eyhxh/3Dprint-mini-RC-excavator-V2/readme/img/bottom.jpeg

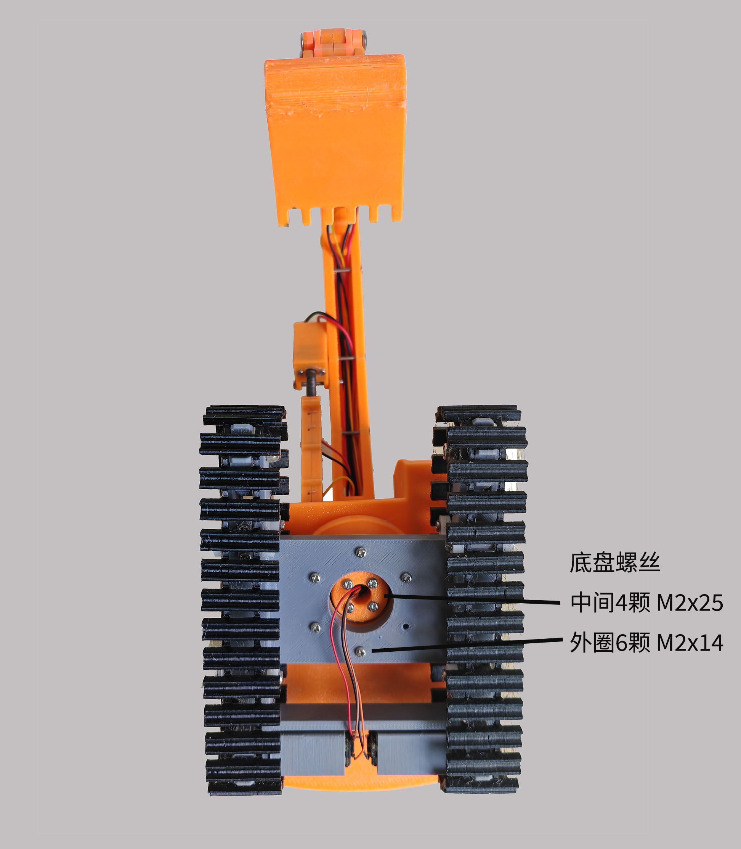
readme/img/bottom.jpeg
