eyhxh/3Dprint-mini-RC-excavator-V2/STL/tpu print/tpu履带29-修正.STL

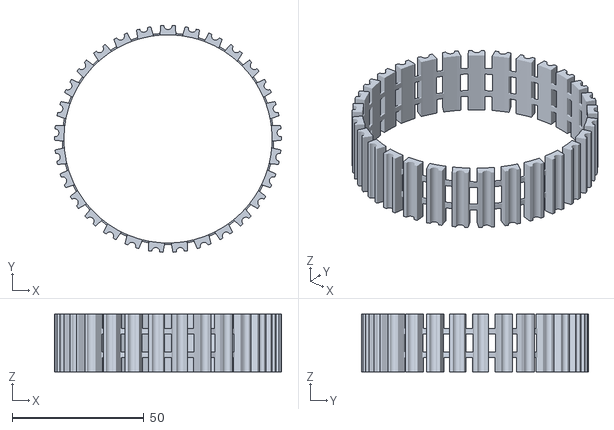
[picture p7: CAD file, 2025-03-01]
STL/tpu print/tpu履带29-修正.STL
86.2 x 86.0 x 22.0
