eyhxh/3Dprint-mini-RC-excavator-V2/STL/装配体1^新旋转机构.STL

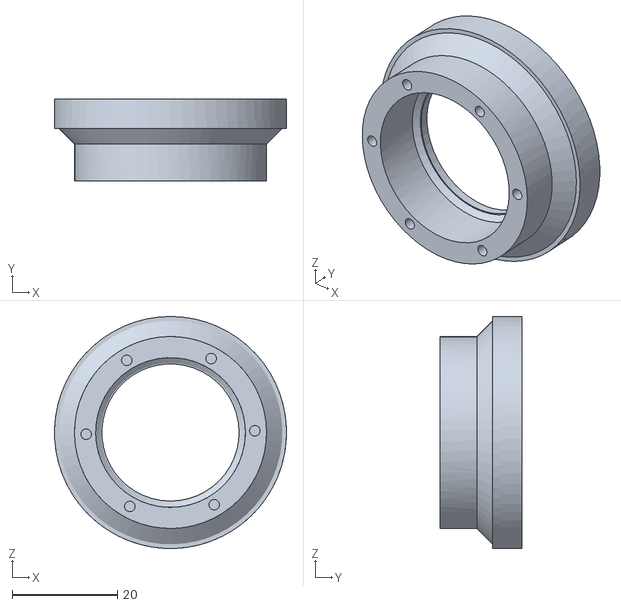
[picture p8: CAD file, 2025-03-01]
STL/装配体1^新旋转机构.STL
44.0 x 15.6 x 44.0
