eyhxh/3Dprint-mini-RC-excavator-V2/STL/试装1 - tpu底盘系统.SLDPRT-1 N20防尘-3.STL

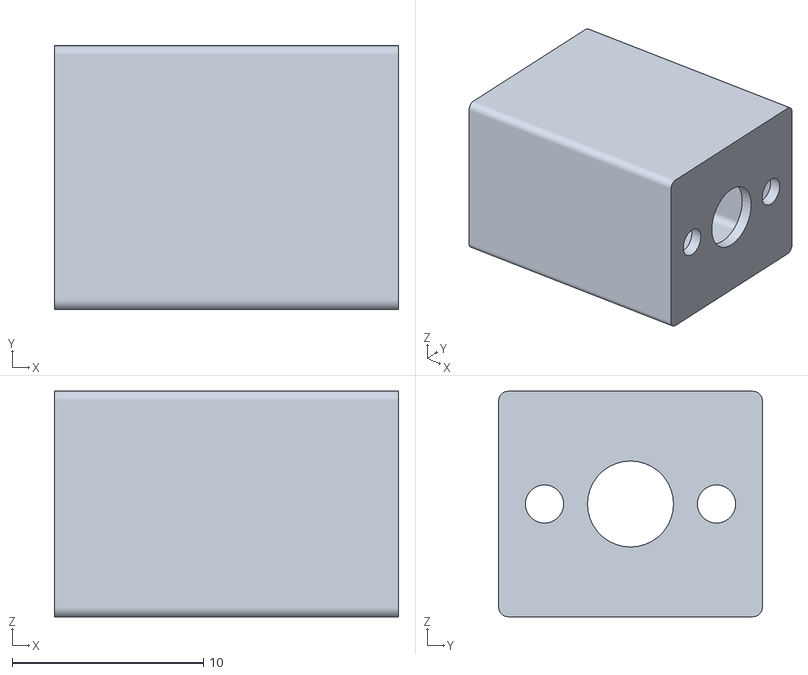
[picture p10: CAD file, 2025-03-01]
STL/试装1 - tpu底盘系统.SLDPRT-1 N20防尘-3.STL
18.0 x 13.8 x 11.8
