eyhxh/3Dprint-mini-RC-excavator-V2/STL/试装1 - tpu底盘系统.SLDPRT-1 tpu底盘-1.STL

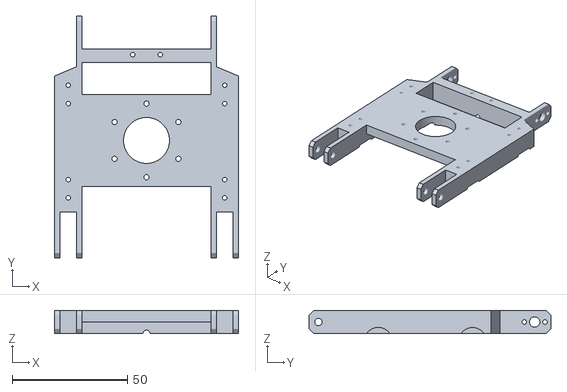
[picture p11: CAD file, 2025-03-01]
STL/试装1 - tpu底盘系统.SLDPRT-1 tpu底盘-1.STL
80.0 x 105.0 x 10.0
