eyhxh/3Dprint-mini-RC-excavator-V2/STL/试装1 - tpu底盘系统.SLDPRT-1 履带电机挡板-1.STL

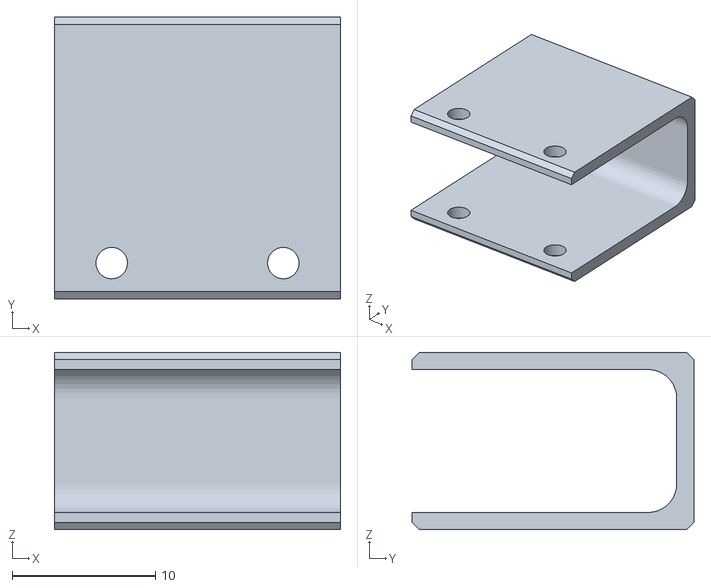
[picture p12: CAD file, 2025-03-01]
STL/试装1 - tpu底盘系统.SLDPRT-1 履带电机挡板-1.STL
20.0 x 19.7 x 12.4
