eyhxh/3Dprint-mini-RC-excavator-V2/STL/试装1 - 主体带推杆系统-1 主体系统-1 主体底-1.STL

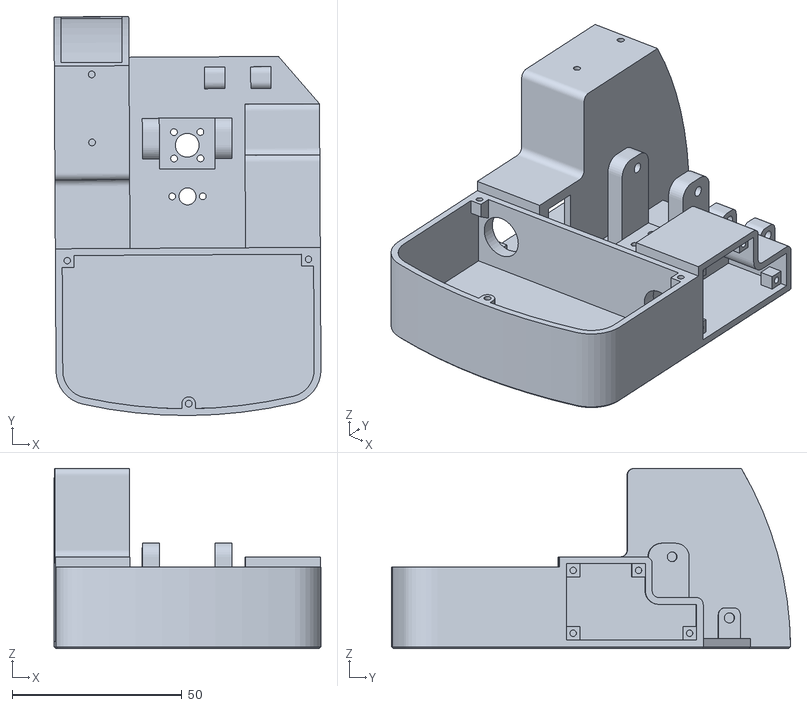
[picture p13: CAD file, 2025-03-01]
STL/试装1 - 主体带推杆系统-1 主体系统-1 主体底-1.STL
78.6 x 117.4 x 53.0
