eyhxh/3Dprint-mini-RC-excavator-V2/STL/试装1 - 主体带推杆系统-1 推杆3-m4-3 新推杆活动杆壳-m4-2.STL

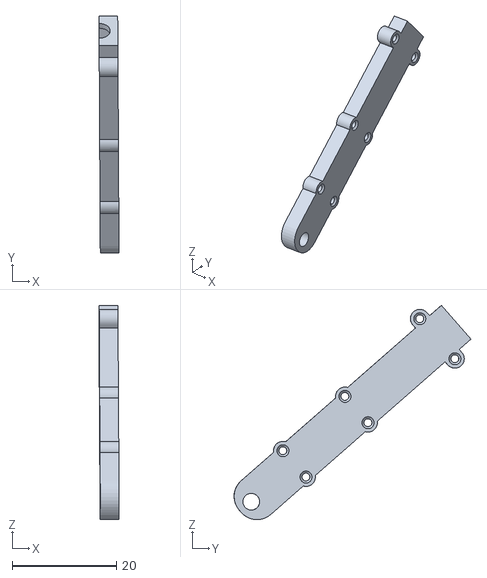
[picture p16: CAD file, 2025-03-01]
STL/试装1 - 主体带推杆系统-1 推杆3-m4-3 新推杆活动杆壳-m4-2.STL
3.86 x 45.4 x 41.1
