eyhxh/3Dprint-mini-RC-excavator-V2/STL/试装1 - 主体带推杆系统-1 主体系统-1 挖斗-1.STL

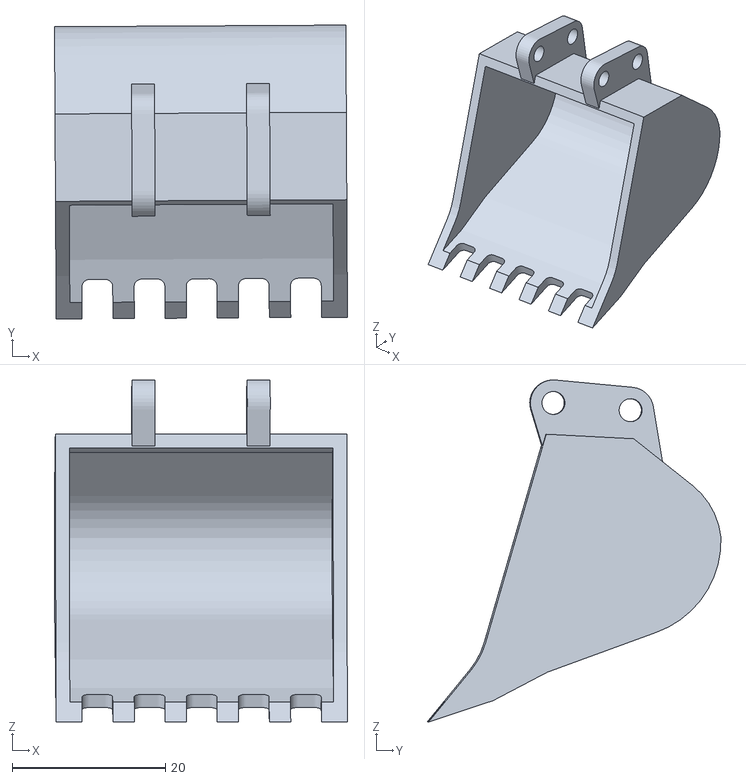
[picture p18: CAD file, 2025-03-01]
STL/试装1 - 主体带推杆系统-1 主体系统-1 挖斗-1.STL
38.2 x 38.3 x 44.6
