eyhxh/3Dprint-mini-RC-excavator-V2/STL/试装1 - 主体带推杆系统-1 主体系统-1 实体1-2.STL

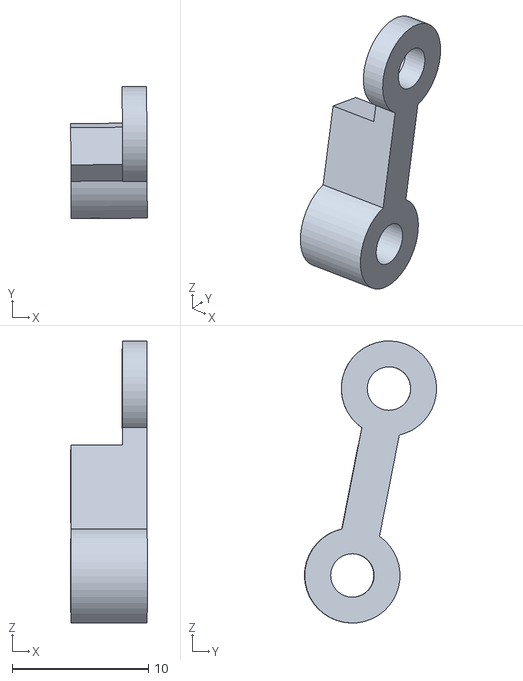
[picture p19: CAD file, 2025-03-01]
STL/试装1 - 主体带推杆系统-1 主体系统-1 实体1-2.STL
5.64 x 9.72 x 20.7
