eyhxh/3Dprint-mini-RC-excavator-V2/STL/试装1 - 新旋转机构-1 外套垫圈-1.STL

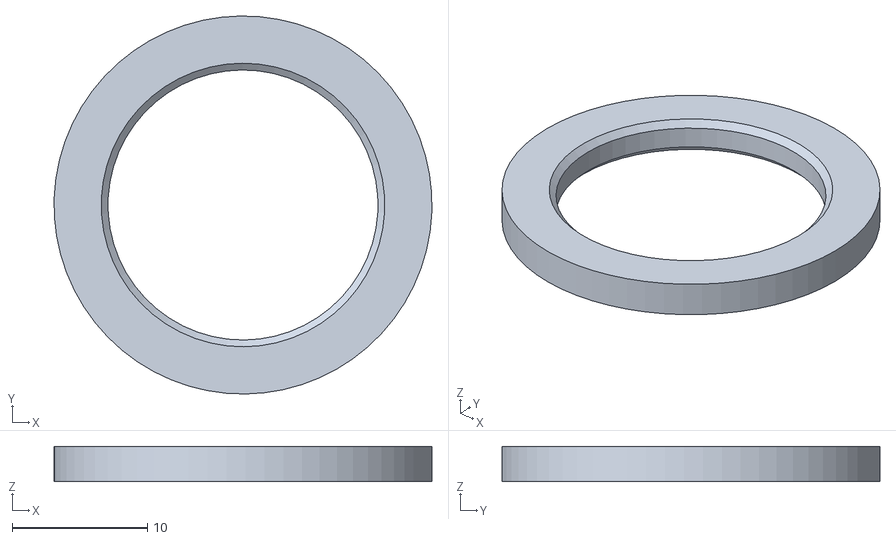
[picture p20: CAD file, 2025-03-01]
STL/试装1 - 新旋转机构-1 外套垫圈-1.STL
28.0 x 28.0 x 2.60
