eyhxh/3Dprint-mini-RC-excavator-V2/STL/试装1 - 主体带推杆系统-1 推杆3-m4-3 推杆2N20防尘固定0.2间隙-1.STL

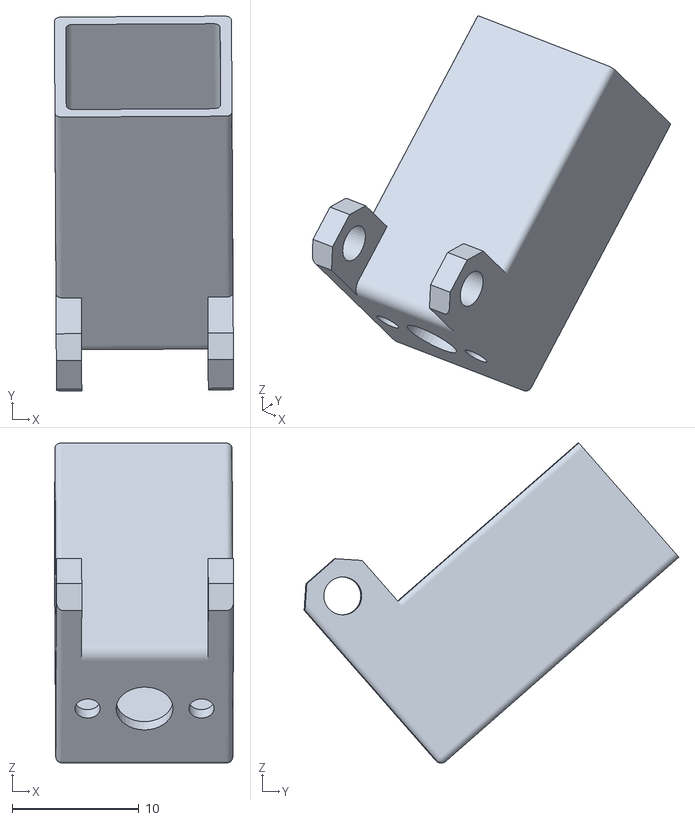
[picture p21: CAD file, 2025-03-01]
STL/试装1 - 主体带推杆系统-1 推杆3-m4-3 推杆2N20防尘固定0.2间隙-1.STL
14.2 x 29.6 x 25.3
