eyhxh/3Dprint-mini-RC-excavator-V2/STL/试装1 - 主体带推杆系统-1 主体系统-1 实体1-1.STL

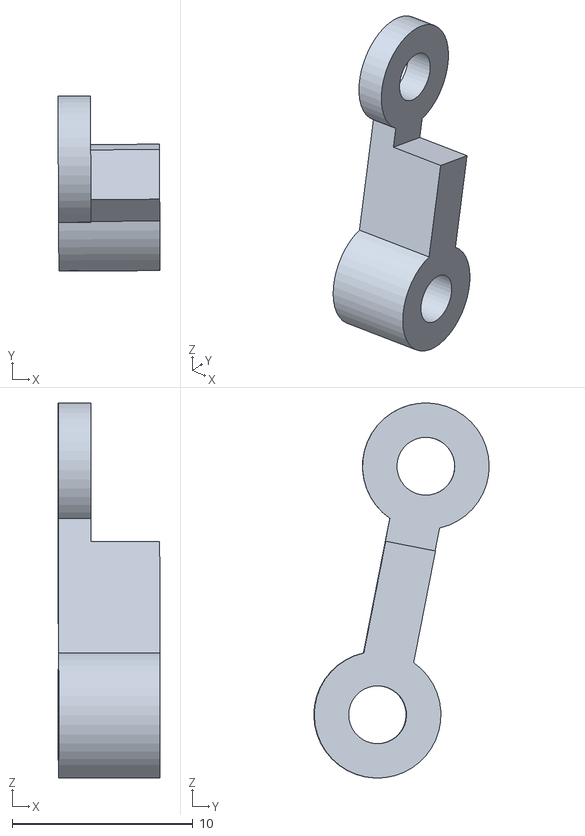
[picture p23: CAD file, 2025-03-01]
STL/试装1 - 主体带推杆系统-1 主体系统-1 实体1-1.STL
5.65 x 9.70 x 20.7
