eyhxh/3Dprint-mini-RC-excavator-V2/STL/试装1 - tpu底盘系统.SLDPRT-1 tpu主动轮-6.STL

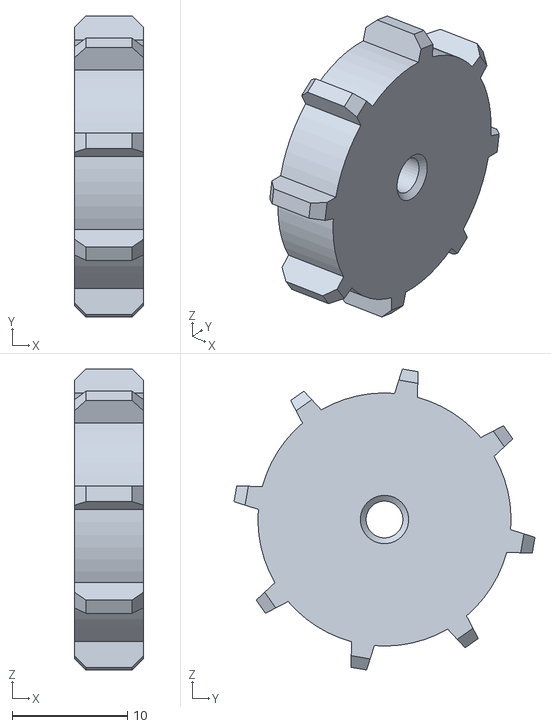
[picture p24: CAD file, 2025-03-01]
STL/试装1 - tpu底盘系统.SLDPRT-1 tpu主动轮-6.STL
6.00 x 26.2 x 26.2
