eyhxh/3Dprint-mini-RC-excavator-V2/STL/试装1 - 主体带推杆系统-1 主体系统-1 电池仓盖^主体系统-1.STL

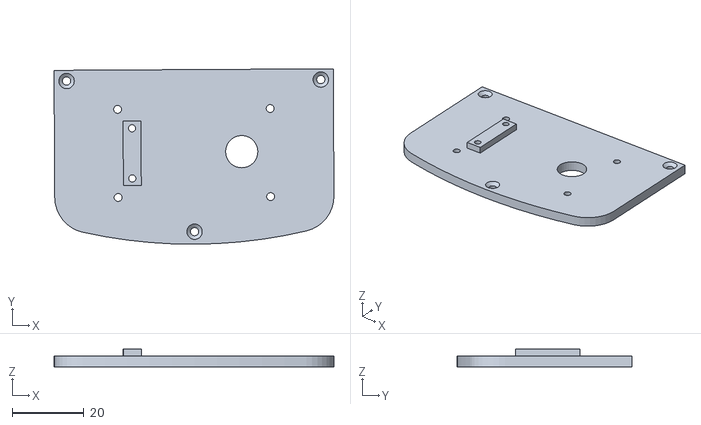
[picture p25: CAD file, 2025-03-01]
STL/试装1 - 主体带推杆系统-1 主体系统-1 电池仓盖^主体系统-1.STL
78.2 x 49.0 x 5.00
