eyhxh/3Dprint-mini-RC-excavator-V2/STL/主轴齿轮适配体间隙0.4.STL

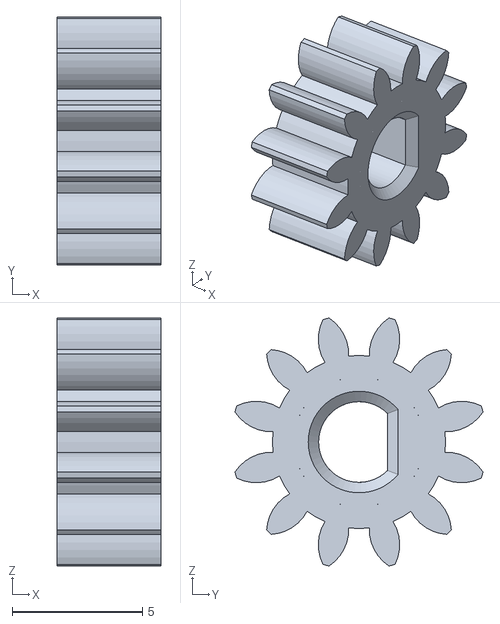
[picture p26: CAD file, 2025-03-01]
STL/主轴齿轮适配体间隙0.4.STL
4.00 x 9.53 x 9.53
