eyhxh/3Dprint-mini-RC-excavator-V2/STL/试装1 - 主体带推杆系统-1 主体系统-1 主控仓盖^主体系统-1.STL

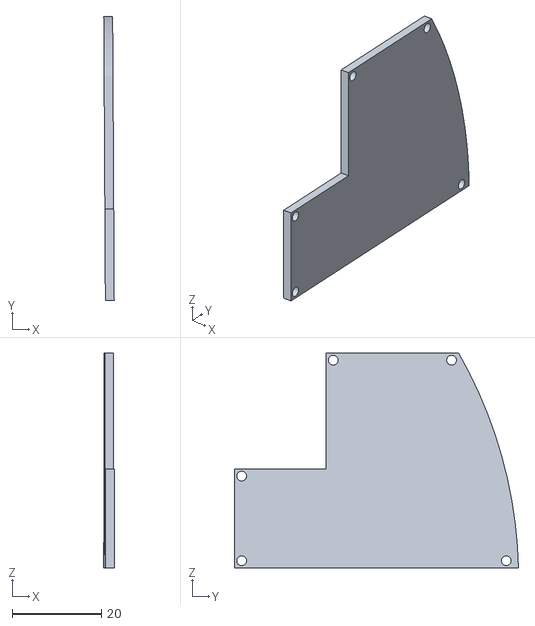
[picture p27: CAD file, 2025-03-01]
STL/试装1 - 主体带推杆系统-1 主体系统-1 主控仓盖^主体系统-1.STL
2.36 x 63.7 x 48.2
