eyhxh/3Dprint-mini-RC-excavator-V2/STL/试装1 - 主体带推杆系统-1 主体系统-1 小臂-1.STL

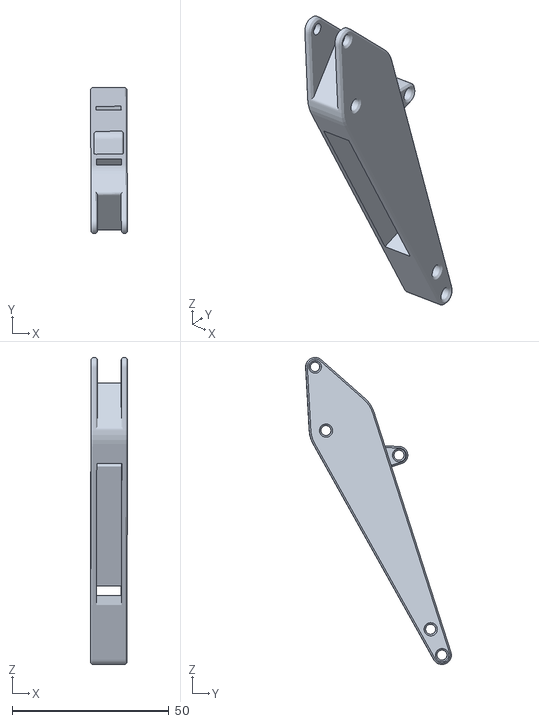
[picture p29: CAD file, 2025-03-01]
STL/试装1 - 主体带推杆系统-1 主体系统-1 小臂-1.STL
11.9 x 46.6 x 98.0
