eyhxh/3Dprint-mini-RC-excavator-V2/STL/试装1 - 主体带推杆系统-1 主体系统-1 挖斗连杆2-2.STL

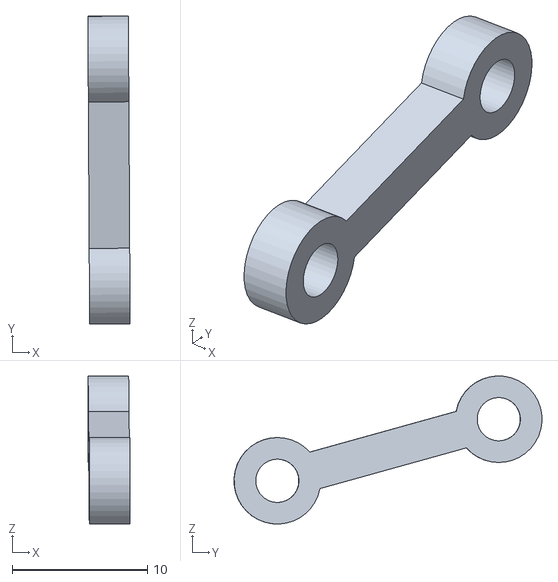
[picture p30: CAD file, 2025-03-01]
STL/试装1 - 主体带推杆系统-1 主体系统-1 挖斗连杆2-2.STL
3.13 x 22.8 x 10.9
