eyhxh/3Dprint-mini-RC-excavator-V2/STL/试装1 - 新旋转机构-1 新内套垫圈-1.STL

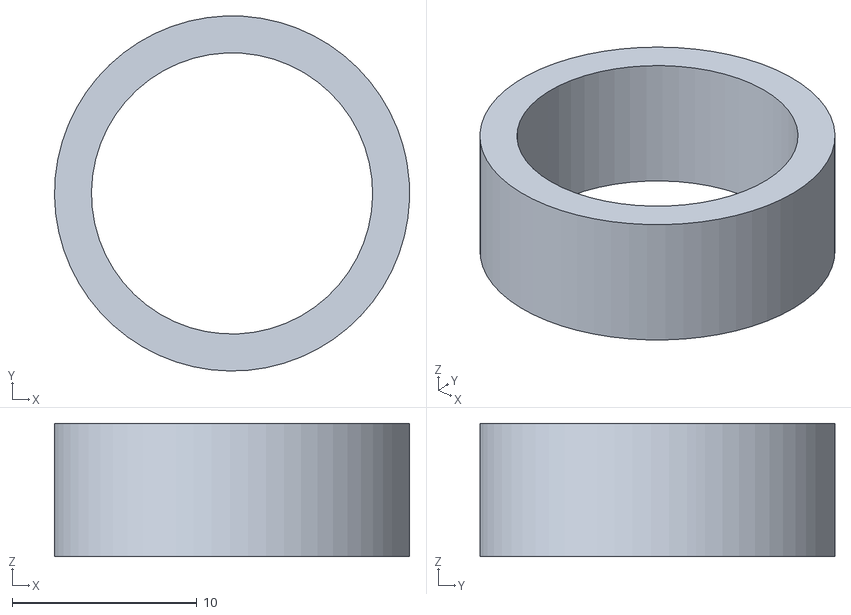
[picture p32: CAD file, 2025-03-01]
STL/试装1 - 新旋转机构-1 新内套垫圈-1.STL
19.2 x 19.2 x 7.20
