eyhxh/3Dprint-mini-RC-excavator-V2/STL/试装1 - 主体带推杆系统-1 主体系统-1 引擎壳-1.STL

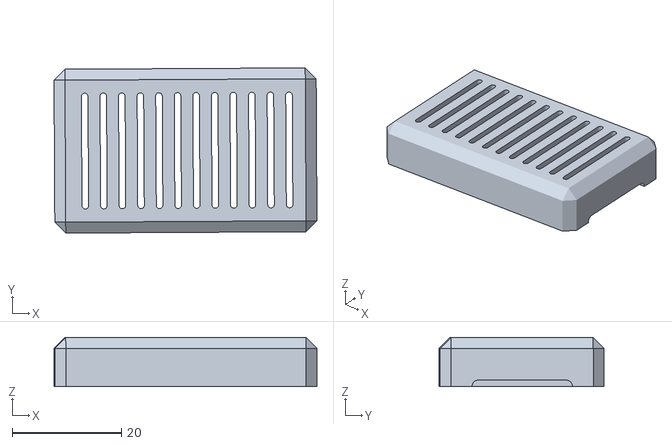
[picture p33: CAD file, 2025-03-01]
STL/试装1 - 主体带推杆系统-1 主体系统-1 引擎壳-1.STL
48.1 x 30.2 x 9.00
