eyhxh/3Dprint-mini-RC-excavator-V2/STL/试装1 - 主体带推杆系统-1 主体系统-1 零件1^主体系统-1.STL

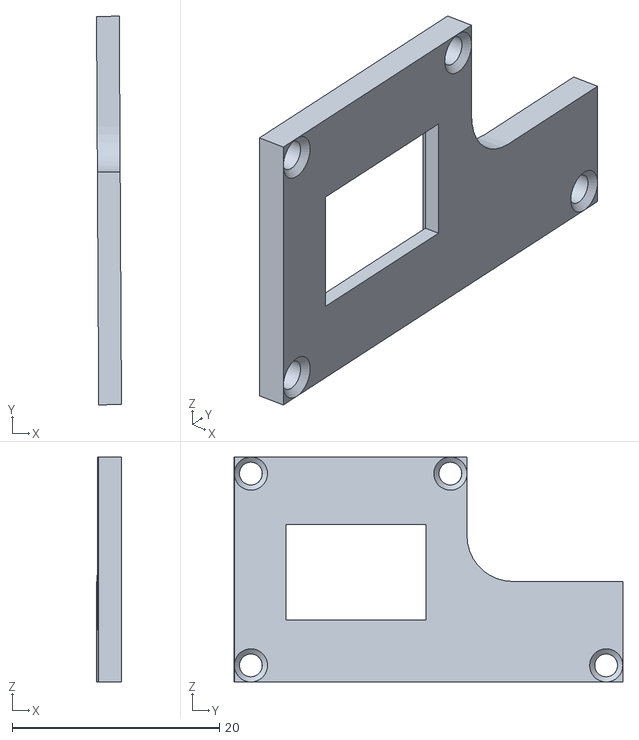
[picture p34: CAD file, 2025-03-01]
STL/试装1 - 主体带推杆系统-1 主体系统-1 零件1^主体系统-1.STL
2.41 x 37.5 x 21.7
