eyhxh/3Dprint-mini-RC-excavator-V2/STL/试装1 - 主体带推杆系统-1 主体系统-1 大臂-1.STL

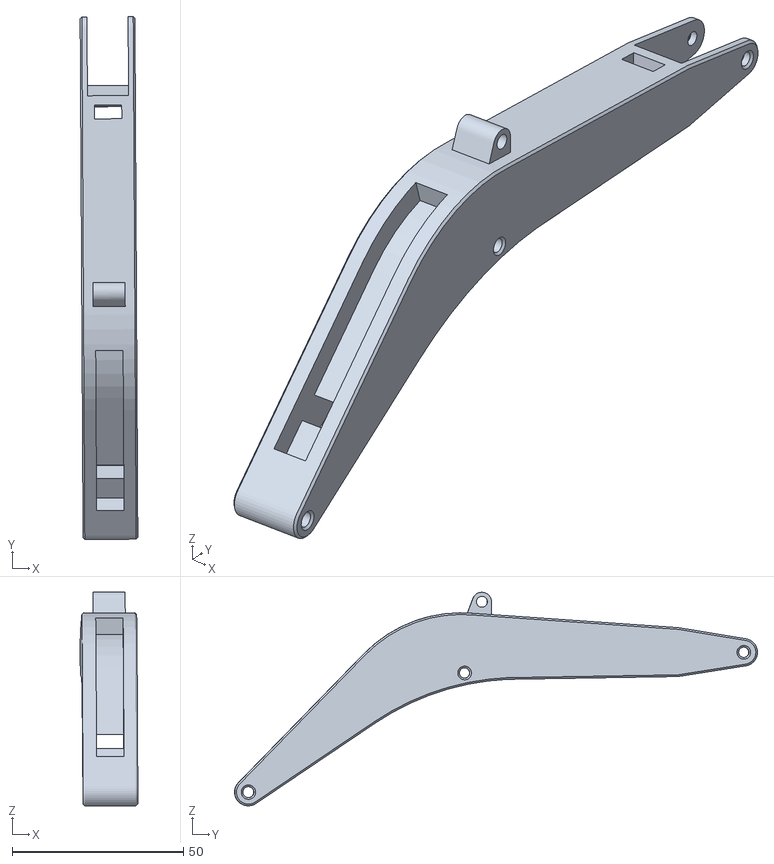
[picture p35: CAD file, 2025-03-01]
STL/试装1 - 主体带推杆系统-1 主体系统-1 大臂-1.STL
16.9 x 152.7 x 62.4
