eyhxh/3Dprint-mini-RC-excavator-V2/STL/试装1 - 主体带推杆系统-1 推杆3-m4-1 新推杆活动杆壳-m4-2.STL

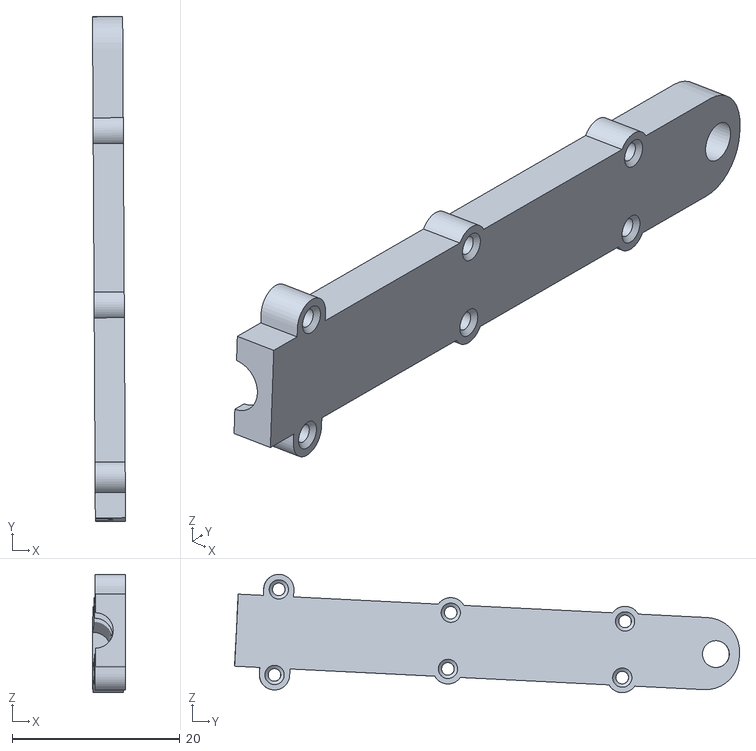
[picture p37: CAD file, 2025-03-01]
STL/试装1 - 主体带推杆系统-1 推杆3-m4-1 新推杆活动杆壳-m4-2.STL
3.94 x 60.2 x 14.1
