eyhxh/3Dprint-mini-RC-excavator-V2/STL/试装1 - tpu底盘系统.SLDPRT-1 轴承盖板-1.STL

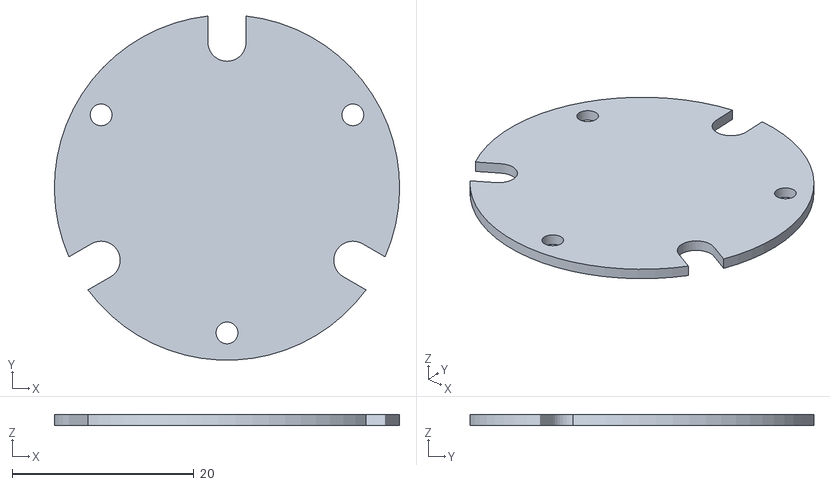
[picture p38: CAD file, 2025-03-01]
STL/试装1 - tpu底盘系统.SLDPRT-1 轴承盖板-1.STL
38.0 x 37.9 x 1.20
