eyhxh/3Dprint-mini-RC-excavator-V2/STL/试装1 - 新旋转机构-1 新内套-1.STL

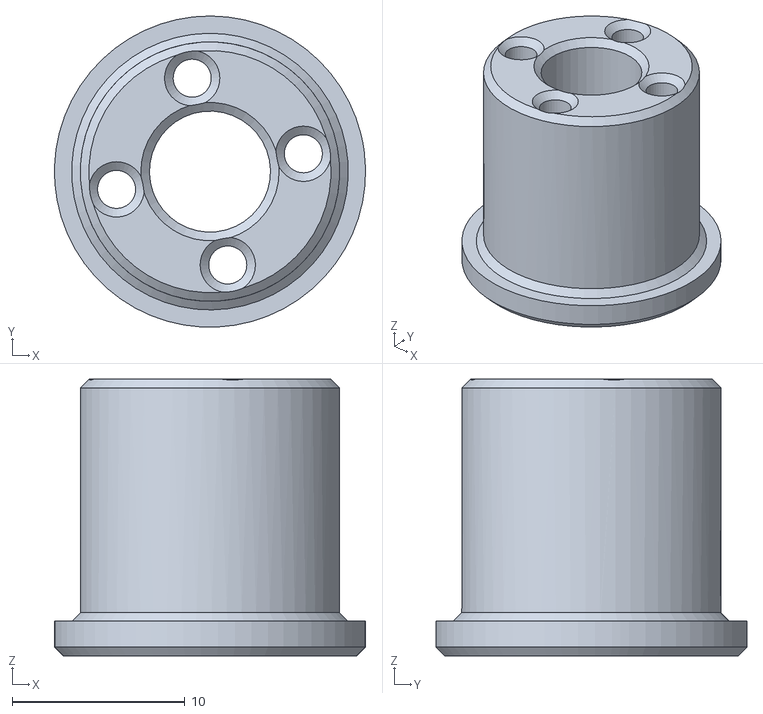
[picture p39: CAD file, 2025-03-01]
STL/试装1 - 新旋转机构-1 新内套-1.STL
18.0 x 18.0 x 16.0
