eyhxh/3Dprint-mini-RC-excavator-V2/STL/试装1 - tpu底盘系统.SLDPRT-1 复件 装配体1^tpu底盘系统.SLDPRT-4 小轮支架2-1.STL

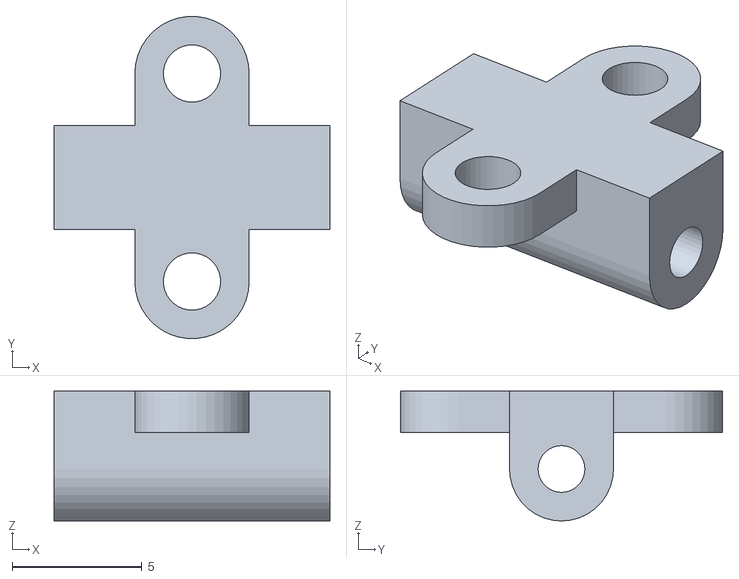
[picture p40: CAD file, 2025-03-01]
STL/试装1 - tpu底盘系统.SLDPRT-1 复件 装配体1^tpu底盘系统.SLDPRT-4 小轮支架2-1.STL
10.6 x 12.4 x 5.00
