eyhxh/3Dprint-mini-RC-excavator-V2/STL/试装1 - 主体带推杆系统-1 N20防尘-1.STL

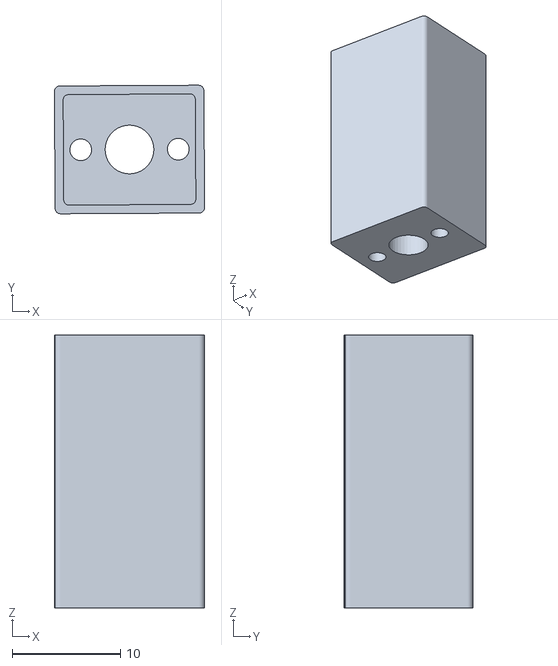
[picture p42: CAD file, 2025-03-01]
STL/试装1 - 主体带推杆系统-1 N20防尘-1.STL
13.9 x 11.9 x 25.2
