eyhxh/3Dprint-mini-RC-excavator-V2/(list of files, cad)

Other CAD files:
STL/试装1 - tpu底盘系统.SLDPRT-1 N20防尘-1.STL
STL/试装1 - tpu底盘系统.SLDPRT-1 tpu主动轮-1.STL
STL/试装1 - 主体带推杆系统-1 主体系统-1 挖斗连杆2-1.STL
STL/试装1 - tpu底盘系统.SLDPRT-1 tpu主动轮-2.STL
