eyhxh/3Dprint-mini-RC-excavator-V2/firmware/rc_rev_v2.2.2_24051801/Core/Src/main.c

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
/* Includes ------------------------------------------------------------------*/
#include "main.h"

/* USER CODE BEGIN Includes */
#include "ci24r1.h"
#include "stdio.h"
#include "SEGGER_RTT.h"
#include "motor.h"

/* USER CODE END Includes */

ADC_HandleTypeDef hadc;
DMA_HandleTypeDef hdma_adc;

TIM_HandleTypeDef htim1;
TIM_HandleTypeDef htim3;
TIM_HandleTypeDef htim16;
TIM_HandleTypeDef htim17;

UART_HandleTypeDef huart1;

void SystemClock_Config(void);
static void MX_GPIO_Init(void);
static void MX_DMA_Init(void);
static void MX_ADC_Init(void);
static void MX_TIM1_Init(void);
static void MX_TIM3_Init(void);
static void MX_USART1_UART_Init(void);
static void MX_TIM16_Init(void);
static void MX_TIM17_Init(void);
/* USER CODE BEGIN 0 */
void print_buf(uint8_t* buf,uint8_t buflen)
{ 
  for(int i = 0; i<buflen; i++)
  {
    SEGGER_RTT_printf(0, "%#x ",buf[i]);
  }
  SEGGER_RTT_printf(0, "\r\n");
  
}

//#define TXMODE
#define ADC_CH_CNT 2
#define ADC_AVG_CNT 10
uint8_t adc_value[ADC_CH_CNT * ADC_AVG_CNT] = {0}; // adc dma buffer

u8 adc_get_val(u8 idx)
{
	int sum = 0;
  for(int i=0; i<ADC_AVG_CNT; i++)
  {
    sum += adc_value[idx + i * ADC_CH_CNT];
  }
  return sum/ADC_AVG_CNT;
}



#define SOFTPWMCHN 4

int SoftPwmDuty[SOFTPWMCHN] = {0,0,0,0};
GPIO_TypeDef* SoftPwmPort[SOFTPWMCHN] = {T2CH1_GPIO_Port,T2CH2_GPIO_Port,T2CH3_GPIO_Port,T2CH4_GPIO_Port};
uint16_t SoftPwmPin[SOFTPWMCHN] = {T2CH1_Pin,T2CH2_Pin,T2CH3_Pin,T2CH4_Pin};

void SoftPwmInit(void)
{
  //nothing to do
}
static u8 counter = 0;
// put in tim17 interrupt
void SoftPwmService(void)
{
    
    int i;


    if(counter == 0)
    {
      for(i=0; i<SOFTPWMCHN; i++)
      {
          if(SoftPwmDuty[i] == 0)
          {
            HAL_GPIO_WritePin(SoftPwmPort[i],SoftPwmPin[i],GPIO_PIN_RESET);
          }   
          else
          {
            HAL_GPIO_WritePin(SoftPwmPort[i],SoftPwmPin[i],GPIO_PIN_SET);
          }
           
      }
      counter++;
    }
    else if(counter >= 10)   
    {
      counter = 0;
      for(i=0; i<SOFTPWMCHN; i++)
      {
					if(SoftPwmDuty[i] == 10)
          {
            HAL_GPIO_WritePin(SoftPwmPort[i],SoftPwmPin[i],GPIO_PIN_SET);
          }   
          else
          {
            HAL_GPIO_WritePin(SoftPwmPort[i],SoftPwmPin[i],GPIO_PIN_RESET);
          }
      }
    }
    else// 1~9   
    {
      for(i=0; i<SOFTPWMCHN; i++)
      {
        if(SoftPwmDuty[i] == counter)
          HAL_GPIO_WritePin(SoftPwmPort[i], SoftPwmPin[i], GPIO_PIN_RESET);
      }
      counter++;
    }

    

}
//ch 0-3 duty 0-1000  
void SoftPwmSetDuty(u8 ch,u16 dutyin)
{
    u8 duty = dutyin / 100;
    
    if(dutyin >= 910) 
      duty = 10;

    if(duty > 10)
        duty = 10;
    if(ch >= 4)
        return;
    SoftPwmDuty[ch] = duty;
}




void limit_init(void)
{
  //cubemax already inital
}

void debounce(u8 originInput,u8 *output,u32 mask,int* bounceTimer)
{
  if (originInput & mask)
  {
    //SEGGER_RTT_printf(0, "max1 trig 1 %d\r\n", HAL_GetTick());
    (*bounceTimer)++;
    if (*bounceTimer >= 5)
    {
      //SEGGER_RTT_printf(0, "max1 trig 2 %d\r\n", HAL_GetTick());
      *bounceTimer = 5; // 一直锁定在这里
      *output |= mask;
    }
    else
    {
      *output &= ~mask;
    }
  }
  else
  {
    *output &= ~mask;
    //SEGGER_RTT_printf(0, "max1 trig 0 %d\r\n", HAL_GetTick());
    *bounceTimer = 0;
  }
}

int Max1timer = 0;
int Max2timer = 0;
int Max3timer = 0;

void limit_check(void)
{
  
  u8 tmp_limit_state = 0;

  // MAX 输入高为trig
  // MIN 输入低为trig

  if (HAL_GPIO_ReadPin(MAX1_GPIO_Port, MAX1_Pin) == SET)
    tmp_limit_state |= LIMIT_MAX1_TRIG;
  if (HAL_GPIO_ReadPin(MIN1_GPIO_Port, MIN1_Pin) == RESET)
    tmp_limit_state |= LIMIT_MIN1_TRIG;
  if (HAL_GPIO_ReadPin(MAX2_GPIO_Port, MAX2_Pin) == SET)
    tmp_limit_state |= LIMIT_MAX2_TRIG;
  if (HAL_GPIO_ReadPin(MIN2_GPIO_Port, MIN2_Pin) == RESET)
    tmp_limit_state |= LIMIT_MIN2_TRIG;
  if (HAL_GPIO_ReadPin(MAX3_GPIO_Port, MAX3_Pin) == SET)
    tmp_limit_state |= LIMIT_MAX3_TRIG;
  if (HAL_GPIO_ReadPin(MIN3_GPIO_Port, MIN3_Pin) == RESET)
    tmp_limit_state |= LIMIT_MIN3_TRIG;

  g_limit_state = tmp_limit_state;

#if 1
  // max trig信号必须要添加防抖功能,否则电机会出现断断续续现象
	debounce(tmp_limit_state, &g_limit_state, LIMIT_MAX1_TRIG, &Max1timer);
	debounce(tmp_limit_state, &g_limit_state, LIMIT_MAX2_TRIG, &Max2timer);
	debounce(tmp_limit_state, &g_limit_state, LIMIT_MAX3_TRIG, &Max3timer);

  
#endif
}

//0 灭  1亮  2快闪  3慢闪  4toggle
uint32_t ledOnTime = 5;
uint32_t ledOffTime = 10;

void ledSetMode(int mode)
{
  if(mode == 0)
  {
    ledOnTime = 100;
    ledOffTime = 100;
  }
  else if(mode == 1)
  {
    ledOnTime = 0;
    ledOffTime = 100;
  }
  else if(mode == 2)
  {
    ledOnTime = 20;
    ledOffTime = 40;
  }
  else if(mode == 3)
  {
    ledOnTime = 100;
    ledOffTime = 200;
  }
  else if(mode == 4)
  {
    ledOnTime = 0;
    ledOffTime = 0;
    HAL_GPIO_TogglePin(GPIOF, GPIO_PIN_6);
  }
}
void ledservice(void)
{
  static uint32_t ledTimerCounter = 0;
  if (ledOnTime != 0 || ledOffTime != 0)
  {
    if (++ledTimerCounter >= ledOnTime)
      HAL_GPIO_WritePin(GPIOF, GPIO_PIN_6, GPIO_PIN_RESET); // led on

    if (ledTimerCounter >= ledOffTime)
    {
      ledTimerCounter = 0;
      HAL_GPIO_WritePin(GPIOF, GPIO_PIN_6, GPIO_PIN_SET); // led off
    }
  }
}

uint8_t connectStatus = 0;
uint32_t lastRevFrame = 0;
void connectService(void)
{
    if (connectStatus)
    {
      uint32_t now = HAL_GetTick();
      if (abs(now - lastRevFrame) >= 50)
      {
        connectStatus = 0;
        ledSetMode(3);
      }
    }
}


/* USER CODE END 0 */

/**
  * @brief  The application entry point.
  * @retval int
  */
int main(void)
{
  /* MCU Configuration--------------------------------------------------------*/

  /* Reset of all peripherals, Initializes the Flash interface and the Systick. */
  HAL_Init();

  /* Configure the system clock */
  SystemClock_Config();

  /* USER CODE BEGIN SysInit */

  HAL_Delay(100);
  SEGGER_RTT_printf(0, "board init\r\n");
  /* USER CODE END SysInit */

  /* Initialize all configured peripherals */
  MX_GPIO_Init();
  MX_DMA_Init();
  MX_ADC_Init();
  MX_TIM1_Init();
  MX_TIM3_Init();
  MX_USART1_UART_Init();
  MX_TIM16_Init();
  MX_TIM17_Init();
  /* USER CODE BEGIN 2 */

  if(HAL_ERROR == HAL_ADCEx_Calibration_Start(&hadc))
  {
    SEGGER_RTT_printf(0, "ADC Calibration error\r\n");
  }
  HAL_ADC_Start_DMA(&hadc, (uint32_t *)adc_value, ADC_CH_CNT * ADC_AVG_CNT);

  motorinit();
  
  uint8_t TX_ADDRESS[5] = {0x34, 0x43, 0x10, 0x10, 0x01};
  uint8_t RX_ADDRESS[5] = {0x34, 0x43, 0x10, 0x10, 0x01};
  ledSetMode(1);
  while (CI24R1_SPI_Test() == HAL_ERROR)
  {
    //HAL_GPIO_WritePin(GPIOF, GPIO_PIN_6, GPIO_PIN_RESET);
    //HAL_Delay(30);
    //HAL_GPIO_WritePin(GPIOF, GPIO_PIN_6, GPIO_PIN_SET);
    HAL_Delay(1000);

  }
  SEGGER_RTT_printf(0, "ci24r1 test succ\r\n");
  ledSetMode(3);
  /* USER CODE END 2 */

  /* Infinite loop */
  /* USER CODE BEGIN WHILE */
  CI24R1_Init();
  CI24R1_SetChannel(122);
#ifdef	TXMODE
	CI24R1_SetTxMode();
#else
  CI24R1_SetRxMode();
#endif
  CI24R1_SetTxAddress(TX_ADDRESS);
  CI24R1_SetRxAddress(RX_ADDRESS);



  HAL_TIM_Base_Start_IT(&htim16);
  HAL_TIM_Base_Start_IT(&htim17);

  uint8_t rxbuf[32];
  uint8_t rxbuflen;
	uint8_t ackpayload[3] = {0};


  while (1)
  {
    /* USER CODE END WHILE */

    /* USER CODE BEGIN 3 */
    // TX
		//HAL_GPIO_TogglePin(GPIOF, GPIO_PIN_6);
    
    #ifdef	TXMODE
    rxbuf[0]++;
		rxbuf[1] = rxbuf[0]+1;
		rxbuf[2] = rxbuf[0]+2;
		rxbuf[3] = rxbuf[0]+4;
    rxbuf[4]= rxbuf[0];
    uint8_t rc = CI24R1_Tx(rxbuf, 0);
    
    #else
 
    CI24R1_WriteACKPload(ackpayload, 3);

    uint8_t rc = CI24R1_Rx(rxbuf, &rxbuflen);
    //print_buf(adc_value,20);
    if(rc & CI24R1_FLAG_RX_READY)
    {
       if(rxbuflen > 0)
      {
        ledSetMode(4);
        connectStatus = 1;
        lastRevFrame = HAL_GetTick();
        motor_set_exp(MOTOR_SMALL_ARM, rxbuf[0], 1);
        motor_set_exp(MOTOR_TURN, rxbuf[1], 1);
        motor_set_exp(MOTOR_BIG_ARM, rxbuf[2], 1);
        motor_set_exp(MOTOR_DIG_BUCKET, rxbuf[3], 1);
        motor_set_exp(MOTOR_LEFT_TRACK, rxbuf[4], 0);
        motor_set_exp(MOTOR_RIGHT_TRACK, rxbuf[6], 1);
        //SEGGER_RTT_printf(0, "rxbuf:%d %d %d %d %d %d\r\n", rxbuf[0],rxbuf[1],rxbuf[2],rxbuf[3],rxbuf[4],rxbuf[6]);
      }
    }

    float vcc = adc_value[1];
    vcc = vcc / 256 * 33.3 * (4.9/1.0);
    //float current = adc_value[0];
    //current = current * 3.33 * 100 / 256 / 0.05 / 20; //10mA per unit
    //SEGGER_RTT_printf(0, "%d %d\r\n", get_adc_val(0),get_adc_val(1));
    ackpayload[0] = adc_get_val(0); 
    ackpayload[1] = (int)vcc; 
    ackpayload[2] = g_limit_state;
    //ackpayload[3] = motor_limit_flagh;
    
    //motor_input_current((u8)current);
    
    
    //motor idx  info
    // 0 Digging buckets 1 small arm 2 big arm 3 turn 4 left track 5 right track



#endif
    
    HAL_Delay(2);
  }
  /* USER CODE END 3 */
}

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
