eyhxh/3Dprint-mini-RC-excavator-V2/firmware/rc_rev_v2.2.2_24051801/rc_rev_v2.2.2_24051801.ioc

Mcu.UserName=STM32F030C8Tx
PA0.Signal=ADC_IN0
PA1.Signal=ADC_IN1
PA10.Signal=S_TIM1_CH3
PA11.Signal=S_TIM1_CH4
PA13.Signal=SYS_SWDIO
PA14.Signal=SYS_SWCLK
PA2.GPIO_Label=T2CH3
PA2.Signal=GPIO_Output
PA3.GPIO_Label=T2CH4
PA3.Signal=GPIO_Output
PA5.GPIO_Label=T2CH1
PA5.Signal=GPIO_Output
PA6.Signal=S_TIM3_CH1
PA7.Signal=S_TIM3_CH2
PA8.Signal=S_TIM1_CH1
PA9.Signal=S_TIM1_CH2
PB0.Signal=S_TIM3_CH3
PB1.Signal=S_TIM3_CH4
PB10.GPIO_Label=MIN3
PB10.Signal=GPIO_Input
PB11.GPIO_Label=MAX3
PB11.Signal=GPIO_Input
PB12.Signal=GPIO_Output
PB13.Signal=GPIO_Output
PB14.Signal=GPIO_Output
PB3.GPIO_Label=T2CH2
PB3.Signal=GPIO_Output
PB4.GPIO_Label=MAX2
PB4.Signal=GPIO_Input
PB5.GPIO_Label=MIN2
PB5.Signal=GPIO_Input
PB6.Signal=USART1_TX
PB7.Signal=USART1_RX
PB8.GPIO_Label=MAX1
PB8.Signal=GPIO_Input
PB9.GPIO_Label=MIN1
PB9.Signal=GPIO_Input
PF6.GPIO_Label=SYSLED
PF6.Signal=GPIO_Output
