eyhxh/3Dprint-mini-RC-excavator-V2/firmware/rc_remote_v2.3.0/Core/Inc/main.h

#define KEY0_Pin GPIO_PIN_2
#define KEY0_GPIO_Port GPIOB
#define IRQ_Pin GPIO_PIN_10
#define IRQ_GPIO_Port GPIOB
#define MOSI_Pin GPIO_PIN_11
#define MOSI_GPIO_Port GPIOB
#define MISO_Pin GPIO_PIN_12
#define MISO_GPIO_Port GPIOB
#define SCK_Pin GPIO_PIN_13
#define SCK_GPIO_Port GPIOB
#define CSN_Pin GPIO_PIN_14
#define CSN_GPIO_Port GPIOB
#define CE_Pin GPIO_PIN_15
#define CE_GPIO_Port GPIOB
#define BEEP_Pin GPIO_PIN_8
#define BEEP_GPIO_Port GPIOA
#define CHARGE_DET_Pin GPIO_PIN_11
#define CHARGE_DET_GPIO_Port GPIOA
#define KEY1_Pin GPIO_PIN_3
#define KEY1_GPIO_Port GPIOB
#define KEY2_Pin GPIO_PIN_4
#define KEY2_GPIO_Port GPIOB
#define KEY3_Pin GPIO_PIN_5
#define KEY3_GPIO_Port GPIOB
