eyhxh/3Dprint-mini-RC-excavator-V2/firmware/rc_remote_v2.3.0/Core/Inc/common.h

#ifndef __COMMON_H__
#define __COMMON_H__

#include "stm32f0xx_hal.h"

#include <string.h>
#include <stdio.h>
#include <stdlib.h>
#include <math.h>

typedef unsigned char uint8_t;
typedef unsigned char u8;
typedef volatile unsigned char vu8;
typedef unsigned short u16;
typedef unsigned int u32;


#endif
