eyhxh/3Dprint-mini-RC-excavator-V2/(notices)

Notices in the files:
firmware/rc_remote_v2.3.0/Core/Inc/main.h:
Copyright (c) 2024 STMicroelectronics.
All rights reserved.
This software is licensed under terms that can be found in the LICENSE file
